sepp89117/Opel_Astra_H_opc_CAN-GaugeV2/CAN-Tools/Visual Studio/CAN-PC/WindowsApp5/Resources/OBD2.png

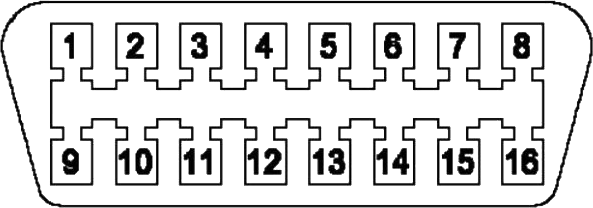
CAN-Tools/Visual Studio/CAN-PC/WindowsApp5/Resources/OBD2.png
