sepp89117/Opel_Astra_H_opc_CAN-GaugeV2/screenshots/211030_ign.jpg

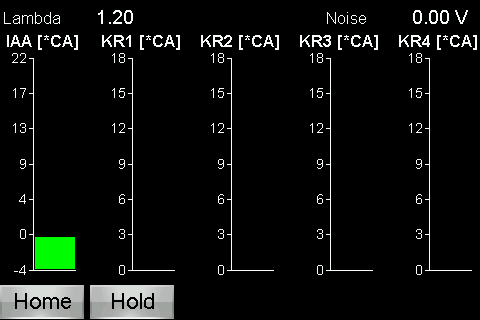
screenshots/211030_ign.jpg
