sepp89117/Opel_Astra_H_opc_CAN-GaugeV2/Display adapter.STL

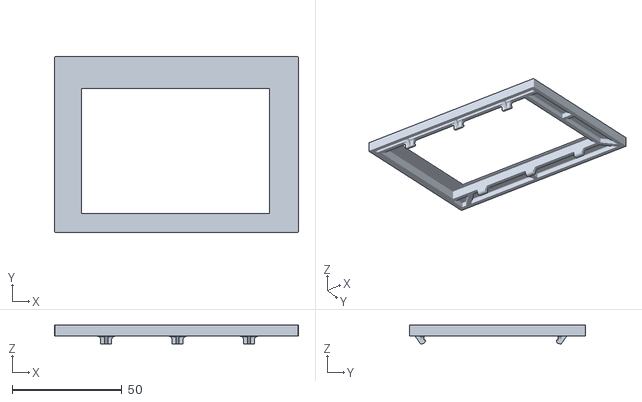
[picture p11: CAD file, 2021-05-02]
Display adapter.STL
111.0 x 80.0 x 8.42
