sepp89117/Opel_Astra_H_opc_CAN-GaugeV2/Circuit board layout files/4zollPlatine.brd

## EAGLE design Circuit board layout files/4zollPlatine.brd (2021-02-12)

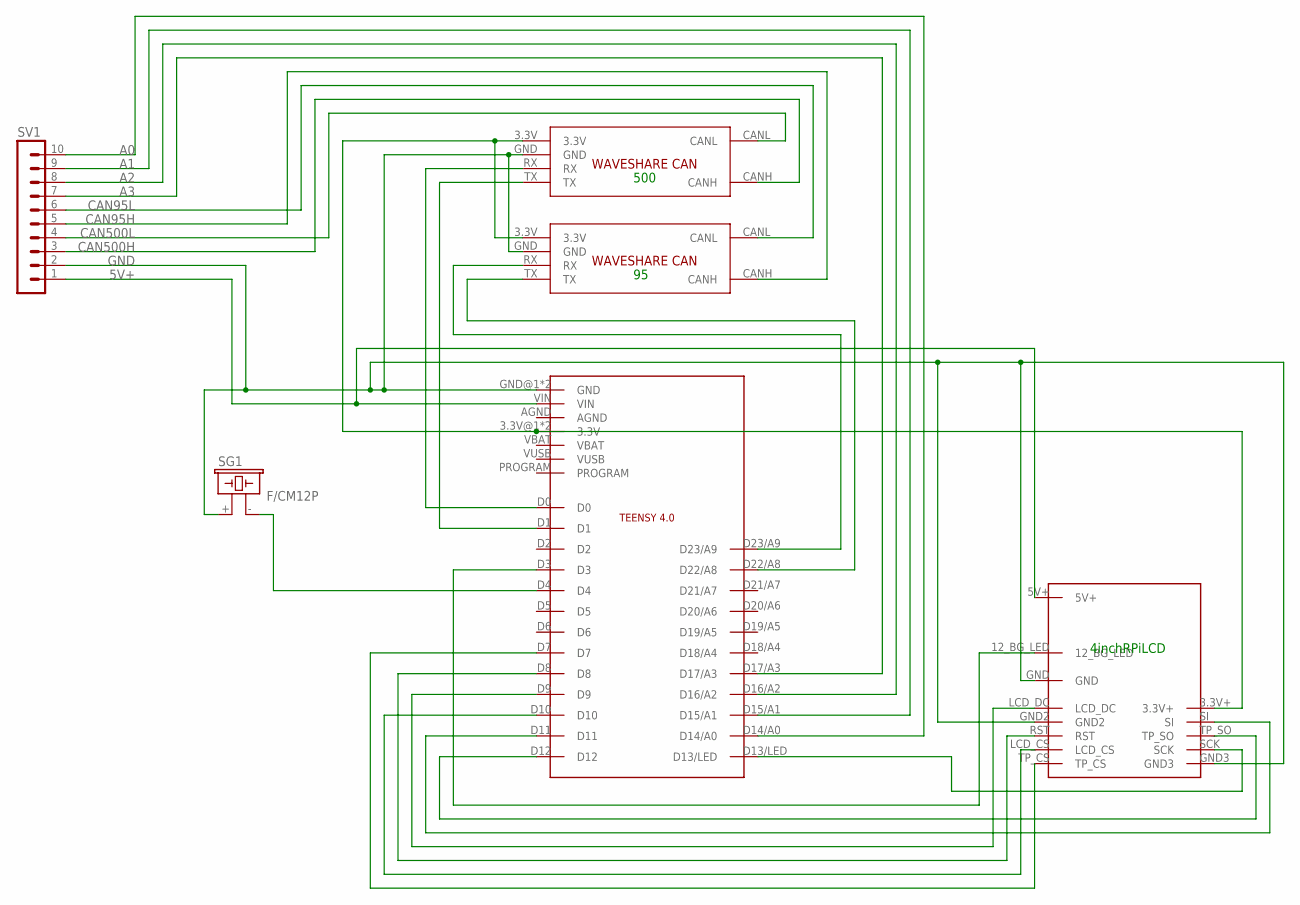
[picture p12: schematic 4zollPlatine.sch]

Parts:
95, 500: CAN_MODULE; CAN_BOARD
SG1: F/CM12P
SV1: MA10-1
U$1: TEENSY4.0
U$2: 4INCH_RPI_LCD_DEV; 4INCH_RPI_LCD_FP

Connections:
5V+: SV1.1, U$1.VIN, U$2.5V+
A0: SV1.10, U$1.D14/A0
A1: SV1.9, U$1.D15/A1
A2: SV1.8, U$1.D16/A2
A3: SV1.7, U$1.D17/A3
CAN95H: 95.CANH, SV1.5
CAN95L: 95.CANL, SV1.6
CAN500H: 500.CANH, SV1.3
CAN500L: 500.CANL, SV1.4
GND: 95.GND, 500.GND, SG1.+ (1), SV1.2, U$1.GND@1 (GND), U$1.GND@2 (GND), U$2.GND, U$2.GND2, U$2.GND3
unnamed: 95.3.3V, 500.3.3V, U$1.3.3V@1 (3.3V), U$1.3.3V@2 (3.3V), U$2.3.3V+
unnamed: U$1.D3, U$2.12_BG_LED
unnamed: SG1.- (2), U$1.D4
unnamed: U$1.D11, U$2.SI
unnamed: 500.RX, U$1.D0
unnamed: 500.TX, U$1.D1
unnamed: 95.RX, U$1.D23/A9
unnamed: 95.TX, U$1.D22/A8
unnamed: U$1.D7, U$2.TP_CS
unnamed: U$1.D10, U$2.LCD_CS
unnamed: U$1.D8, U$2.RST
unnamed: U$1.D9, U$2.LCD_DC
unnamed: U$1.D13/LED, U$2.SCK
unnamed: U$1.D12, U$2.TP_SO

Notes on the sheet:
500
4inchRPiLCD

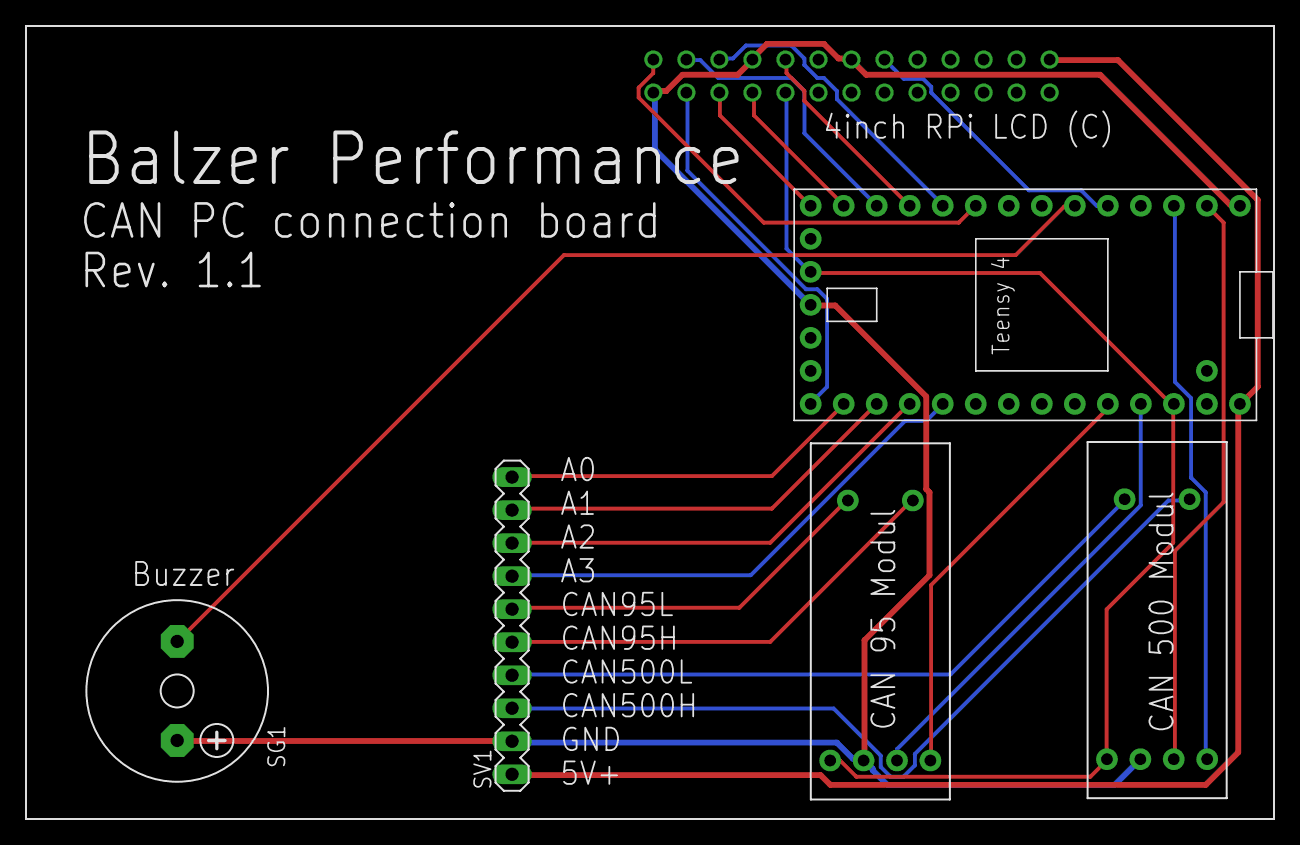
[picture p13: board 4zollPlatine.brd from above]

Board: 2 copper layers, 96.0 x 61.0 mm, 6 parts (0 on the bottom side), 24 nets.
