sepp89117/Opel_Astra_H_opc_CAN-GaugeV2/opc3BC_XL/strings.h

#ifdef DE //Deutsch
//Max-Vals
const PROGMEM char strMaxVals[] = "Maximalwerte";
const PROGMEM char strAccMon[] = "Beschleunigungs-Monitor";
const PROGMEM char strFuelMon[] = "Verbrauchs-Monitor";
const PROGMEM char strSettings[] = "Einstellungen";
const PROGMEM char strCoolant[] = "Motortemperatur";
const PROGMEM char strBoost[] = "Saugrohrdruck";
const PROGMEM char strIAT[] = "Ladelufttemp.";
const PROGMEM char strRPM[] = "Motordrehzahl";
const PROGMEM char strRpmUnit[] = "U / min";
const PROGMEM char strIgnTime[] = "Zuendzeitpunkt";
const PROGMEM char strIgnTimeUnit[] = "* vor OT";
const PROGMEM char strMaf[] = "Luftmasse";
const PROGMEM char strInjUt[] = "Injektorauslastung";
const PROGMEM char strEngStarts[] = "Motorstarts";
const PROGMEM char strPower[] = "Leistung";
const PROGMEM char strTorque[] = "Drehmoment";
const PROGMEM char strConsume[] = "Verbrauch";
//Acc-Monitor
const PROGMEM char strSpeed[] = "Geschwindigkeit";
const PROGMEM char strOdoDev[] = "Tachoabweichung";
//Fuel-View
const PROGMEM char strAvCons[] = "Durchschnittsverbrauch";
const PROGMEM char strAbsCons[] = "Absolutverbrauch";
const PROGMEM char strAvSpeed[] = "Durchschnittsgeschwindigkeit";
const PROGMEM char strDrivDist[] = "Fahrstrecke";
const PROGMEM char strDrivTime[] = "Fahrzeit";
//Settings
const PROGMEM char strSkipLogo[] = "Boot-Logo ueberspringen";
const PROGMEM char strMaxLcdBr[] = "Maximale LCD-Helligkeit";
const PROGMEM char strMinLcdBr[] = "Minimale LCD-Helligkeit";
const PROGMEM char strhandleRVolume[] = "Lautstaerke mit R-Gang anpassen";
const PROGMEM char strPlayAlarms[] = "Alarme aktivieren";
//Infos
const PROGMEM char strNoEcu[] = "ECU nicht verbunden !";
const PROGMEM char strLowFuel[] = "Kraftstoffstand niedrig!";
const PROGMEM char strCheckFl[] = "Fluessigkeiten pruefen !";
const PROGMEM char strHBR[] = "Fernlicht rechts";
const PROGMEM char strHBL[] = "Fernlicht links";
const PROGMEM char strPLR[] = "Standlicht rechts";
const PROGMEM char strPLL[] = "Standlicht links";
const PROGMEM char strLBR[] = "Abblendl. rechts";
const PROGMEM char strLBL[] = "Abblendl. links";
const PROGMEM char strBrFlE[] = "Bremsfl. leer!";
const PROGMEM char strRFL[] = "Nebelschlussleuchte";
const PROGMEM char strRevLR[] = "Rueckfahrlicht R";
const PROGMEM char strRevLL[] = "Rueckfahrlicht L";
const PROGMEM char strTSRR[] = "Blinker HR";
const PROGMEM char strTSRL[] = "Blinker HL";
const PROGMEM char strRLR[] = "Ruecklicht rechts";
const PROGMEM char strRLL[] = "Ruecklicht links";
const PROGMEM char strBLR[] = "Bremslicht rechts";
const PROGMEM char strBLL[] = "Bremslicht links";
const PROGMEM char strCoolLev[] = "Kuehlmittelstand!";
const PROGMEM char strWashLev[] = "Scheibenwaschwasser!";
//DTC View
const PROGMEM char strDelDTCs[] = "Loesche Fehlercodes...";
const PROGMEM char strNoDTCs[] = "Keine Fehlercodes";
const PROGMEM char strNoResp[] = "Keine Rueckmeldung von ECU";
//DTC verbose
const PROGMEM char strUnknwn[] = "Unbekannt";
const PROGMEM char strP00xx[] = "Sensor Umgebungslufttemperatur";
const PROGMEM char strP010x[] = "Luftmassenmesser";
const PROGMEM char strP0110[] = "Sensor Ansauglufttemperatur";
const PROGMEM char strP0115[] = "Sensor Kuehlmitteltemperatur";
const PROGMEM char strP012x[] = "Pedalpositionsgeber A";
const PROGMEM char strP013x[] = "Lambdasonde";
const PROGMEM char strP014x[] = "Lambdasonde Heizkreis";
const PROGMEM char strP017x[] = "Kraftstoffkorrektur";
const PROGMEM char strP020x[] = "Einspritzventil";
const PROGMEM char strP021x[] = "Motordrehzahl zu groß";
const PROGMEM char strP022x[] = "Pedalpositionsgeber B";
const PROGMEM char strP0230[] = "Kraftstoffpumpe Primaerkreis";
const PROGMEM char strP0235[] = "Ladedruckgeber";
const PROGMEM char strP024x[] = "Ladedruckregelventil";
const PROGMEM char strP0300[] = "Fehlzuendung mehrere Zylinder";
const PROGMEM char strP030x[] = "Fehlzuendung Zylinder";
const PROGMEM char strP031x[] = "Fehlzuendung bei leerem Tank";
const PROGMEM char strP032x[] = "Klopfsensor";
const PROGMEM char strP033x[] = "Kurbelwellensensor";
const PROGMEM char strP034x[] = "Nockenwellensensor";
const PROGMEM char strP044x[] = "Tankentlueftungssystem";
const PROGMEM char strP046x[] = "Kraftstoffstandsensor";
const PROGMEM char strP050x[] = "Fahrzeuggeschwindigkeitssignal";
const PROGMEM char strP052x[] = "Oeldruckschalter";
const PROGMEM char strP053x[] = "Klimaanlagendruck";
const PROGMEM char strP057x[] = "Bremslichtschalter";
const PROGMEM char strP060x[] = "Klopfsensor Schaltkreis";
const PROGMEM char strP062x[] = "Generator Regelung";
const PROGMEM char strP065x[] = "MIL Fehler";
const PROGMEM char strP07xx[] = "Kupplungsschalter";

#elif defined  EN //English
const PROGMEM char strNoEcu[] = "ECU not connected!";
const PROGMEM char strLowFuel[] = "Fuel level is low!";
const PROGMEM char strCheckFl[] = "Check fluids !";
const PROGMEM char strMaxVals[] = "Max values";
const PROGMEM char strAccMon[] = "Acceleration Monitor";
const PROGMEM char strFuelMon[] = "Fuel Monitor";
const PROGMEM char strSettings[] = "Settings";
const PROGMEM char strCoolant[] = "Coolant";
const PROGMEM char strBoost[] = "Boost";
const PROGMEM char strIAT[] = "Intake temp.";
const PROGMEM char strRPM[] = "Engine revs";
const PROGMEM char strRpmUnit[] = "rpm";
const PROGMEM char strIgnTime[] = "Ignition time";
const PROGMEM char strIgnTimeUnit[] = "* before TDC";
const PROGMEM char strMaf[] = "Air mass";
const PROGMEM char strInjUt[] = "Injector utilization";
const PROGMEM char strEngStarts[] = "Engine starts";
const PROGMEM char strPower[] = "Power";
const PROGMEM char strTorque[] = "Torque";
const PROGMEM char strConsume[] = "Consumption";
const PROGMEM char strSpeed[] = "Speed";
const PROGMEM char strOdoDev[] = "Speedometer dev.";
const PROGMEM char strAvCons[] = "Average consumption";
const PROGMEM char strAbsCons[] = "Absolute consumption";
const PROGMEM char strAvSpeed[] = "Average speed";
const PROGMEM char strDrivDist[] = "Driving distance";
const PROGMEM char strDrivTime[] = "Travel time";
const PROGMEM char strSkipLogo[] = "Skip boot logo";
const PROGMEM char strMaxLcdBr[] = "Maximum LCD brightness";
const PROGMEM char strMinLcdBr[] = "Minimum LCD brightness";
const PROGMEM char strhandleRVolume[] = "Adjust volume with R-gear";
const PROGMEM char strPlayAlarms[] = "Activate alarms";
const PROGMEM char strHBR[] = "High beam right";
const PROGMEM char strHBL[] = "High beam left";
const PROGMEM char strPLR[] = "Parking light right";
const PROGMEM char strPLL[] = "Parking light left";
const PROGMEM char strLBR[] = "Low beam right";
const PROGMEM char strLBL[] = "Low beam left";
const PROGMEM char strBrFlE[] = "Brake fl. empty!";
const PROGMEM char strRFL[] = "Rear fog light";
const PROGMEM char strRevLR[] = "Reversing light R";
const PROGMEM char strRevLL[] = "Reversing light L";
const PROGMEM char strTSRR[] = "Turn signal R";
const PROGMEM char strTSRL[] = "Turn signal L";
const PROGMEM char strRLR[] = "Taillight right";
const PROGMEM char strRLL[] = "Taillight left";
const PROGMEM char strBLR[] = "Brake light right";
const PROGMEM char strBLL[] = "Brake light left";
const PROGMEM char strCoolLev[] = "Coolant level!";
const PROGMEM char strWashLev[] = "Washer fluid!";
const PROGMEM char strDelDTCs[] = "Clear error codes ...";
const PROGMEM char strNoDTCs[] = "No error codes";
const PROGMEM char strNoResp[] = "No response from ECU ";
const PROGMEM char strUnknwn[] = "Unknown";
const PROGMEM char strP00xx[] = "Sensor ambient air temperature";
const PROGMEM char strP010x[] = "air mass meter";
const PROGMEM char strP0110[] = "Sensor intake air temperature";
const PROGMEM char strP0115[] = "Sensor coolant temperature";
const PROGMEM char strP012x[] = "Pedal position transmitter A";
const PROGMEM char strP013x[] = "Lambda probe";
const PROGMEM char strP014x[] = "Lambda probe heating circuit";
const PROGMEM char strP017x[] = "fuel correction";
const PROGMEM char strP020x[] = "injector";
const PROGMEM char strP021x[] = "Motor speed too high";
const PROGMEM char strP022x[] = "Pedal position transmitter B";
const PROGMEM char strP0230[] = "fuel pump primary circuit";
const PROGMEM char strP0235[] = "boost pressure sensor";
const PROGMEM char strP024x[] = "boost pressure control valve";
const PROGMEM char strP0300[] = "Multiple cylinders misfire";
const PROGMEM char strP030x[] = "misfire on cylinder";
const PROGMEM char strP031x[] = "Incorrect ignition when the tank is empty";
const PROGMEM char strP032x[] = "knock sensor";
const PROGMEM char strP033x[] = "crankshaft sensor";
const PROGMEM char strP034x[] = "camshaft sensor";
const PROGMEM char strP044x[] = "Tank ventilation system";
const PROGMEM char strP046x[] = "fuel level sensor";
const PROGMEM char strP050x[] = "vehicle speed signal";
const PROGMEM char strP052x[] = "Oil pressure switch";
const PROGMEM char strP053x[] = "air conditioning pressure";
const PROGMEM char strP057x[] = "brake light switch";
const PROGMEM char strP060x[] = "Knock Sensor Circuit";
const PROGMEM char strP062x[] = "Generator control";
const PROGMEM char strP065x[] = "MIL error";
const PROGMEM char strP07xx[] = "clutch switch";

#elif defined FR //France
const PROGMEM char strNoEcu[] = "ECU non connecte!";
const PROGMEM char strLowFuel[] = "Le niveau de carburant est bas!";
const PROGMEM char strCheckFl[] = "Verifiez les fluides!";
const PROGMEM char strMaxVals[] = "Valeurs maximales";
const PROGMEM char strAccMon[] = "Moniteur d'acceleration";
const PROGMEM char strFuelMon[] = "Moniteur de carburant";
const PROGMEM char strSettings[] = "Parametres";
const PROGMEM char strCoolant[] = "Liquide de refroidissement";
const PROGMEM char strBoost[] = "Pression du collecteur";
const PROGMEM char strIAT[] = "Temp d'admission.";
const PROGMEM char strRPM[] = "Tours du moteur";
const PROGMEM char strRpmUnit[] = "rpm";
const PROGMEM char strIgnTime[] = "Temps d'allumage";
const PROGMEM char strIgnTimeUnit[] = "* avant TDC";
const PROGMEM char strMaf[] = "Masse d'air";
const PROGMEM char strInjUt[] = "Utilisation de l'injecteur";
const PROGMEM char strEngStarts[] = "Le moteur demarre";
const PROGMEM char strPower[] = "Puissance";
const PROGMEM char strTorque[] = "Couple";
const PROGMEM char strConsume[] = "Consommation";
const PROGMEM char strSpeed[] = "Vitesse";
const PROGMEM char strOdoDev[] = "Compteur de vitesse dev.";
const PROGMEM char strAvCons[] = "Consommation moyenne";
const PROGMEM char strAbsCons[] = "Consommation absolue";
const PROGMEM char strAvSpeed[] = "Vitesse moyenne";
const PROGMEM char strDrivDist[] = "Distance parcourue";
const PROGMEM char strDrivTime[] = "Temps de trajet";
const PROGMEM char strSkipLogo[] = "Ignorer le logo de demarrage";
const PROGMEM char strMaxLcdBr[] = "Luminosite maximale de l'ecran LCD";
const PROGMEM char strMinLcdBr[] = "Luminosite minimale de l'ecran LCD";
const PROGMEM char strhandleRVolume[] = "Reglez volume avec engrenage R";
const PROGMEM char strPlayAlarms[] = "Activer les alarmes";
const PROGMEM char strHBR[] = "Feux de route a droite";
const PROGMEM char strHBL[] = "Feux de route gauche";
const PROGMEM char strPLR[] = "Feu de stationnement a droite";
const PROGMEM char strPLL[] = "Feu de stationnement gauche";
const PROGMEM char strLBR[] = "Feu de croisement a droite";
const PROGMEM char strLBL[] = "Feu de croisement gauche";
const PROGMEM char strBrFlE[] = "Frein fl. vide!";
const PROGMEM char strRFL[] = "Feu antibrouillard arriere";
const PROGMEM char strRevLR[] = "Feu de recul R";
const PROGMEM char strRevLL[] = "Feu de recul L";
const PROGMEM char strTSRR[] = "Clignotant R";
const PROGMEM char strTSRL[] = "Clignotant L";
const PROGMEM char strRLR[] = "Feu arriere droit";
const PROGMEM char strRLL[] = "Feu arriere gauche";
const PROGMEM char strBLR[] = "Feu stop a droite";
const PROGMEM char strBLL[] = "Feu stop gauche";
const PROGMEM char strCoolLev[] = "Niveau liq. refroidissement!";
const PROGMEM char strWashLev[] = "Liquide lave-glace!";
const PROGMEM char strDelDTCs[] = "Effacer les codes d'erreur ...";
const PROGMEM char strNoDTCs[] = "Aucun code d'erreur";
const PROGMEM char strNoResp[] = "Aucune reponse de l'ECU";
const PROGMEM char strUnknwn[] = "Unknown";
const PROGMEM char strP00xx[] = "Temperature de l'air ambiant du capteur";
const PROGMEM char strP010x[] = "Debitmetre d'air massique";
const PROGMEM char strP0110[] = "Temperature de l'air d'admission du capteur";
const PROGMEM char strP0115[] = "Temperature du liquide de refroidissement du capteur";
const PROGMEM char strP012x[] = "Transmetteur de position de pedale A";
const PROGMEM char strP013x[] = "Sonde Lambda";
const PROGMEM char strP014x[] = "Circuit de chauffage de la sonde Lambda";
const PROGMEM char strP017x[] = "Correction de carburant";
const PROGMEM char strP020x[] = "Injecteur";
const PROGMEM char strP021x[] = "Vitesse du moteur trop elevee";
const PROGMEM char strP022x[] = "Transmetteur de position de pedale B";
const PROGMEM char strP0230[] = "Circuit primaire de la pompe a carburant";
const PROGMEM char strP0235[] = "Capteur de pression de suralimentation";
const PROGMEM char strP024x[] = "Vanne de regulation de pression de suralimentation";
const PROGMEM char strP0300[] = "Plusieurs cylindres ont des rates d'allumage";
const PROGMEM char strP030x[] = "Rate d'allumage sur le cylindre";
const PROGMEM char strP031x[] = "Allumage incorrect lorsque le reservoir est vide";
const PROGMEM char strP032x[] = "Capteur de cliquetis";
const PROGMEM char strP033x[] = "Capteur de vilebrequin";
const PROGMEM char strP034x[] = "Capteur d'arbre a cames";
const PROGMEM char strP044x[] = "Systeme de ventilation du reservoir";
const PROGMEM char strP046x[] = "Capteur de niveau de carburant";
const PROGMEM char strP050x[] = "Signal de vitesse du vehicule";
const PROGMEM char strP052x[] = "Pressostat d'huile";
const PROGMEM char strP053x[] = "Pression de climatisation";
const PROGMEM char strP057x[] = "Interrupteur des feux stop";
const PROGMEM char strP060x[] = "Circuit du capteur de cliquetis";
const PROGMEM char strP062x[] = "Contrôle du generateur";
const PROGMEM char strP065x[] = "Erreur MIL";
const PROGMEM char strP07xx[] = "Interrupteur d'embrayage";

#elif defined RO //Romanian
const PROGMEM char strMaxVals[] = "valori maxime";
const PROGMEM char strAccMon[] = "Monitor accelerare";
const PROGMEM char strFuelMon[] = "Monitor consum";
const PROGMEM char strSettings[] = "Setari";
const PROGMEM char strCoolant[] = "temperatura motorului";
const PROGMEM char strBoost[] = "presiunea galeriei de admisie";
const PROGMEM char strIAT[] = "Temp. aer de incarcare.";
const PROGMEM char strRPM[] = "viteza motorului";
const PROGMEM char strRpmUnit[] = "RPM";
const PROGMEM char strIgnTime[] = "timp de aprindere";
const PROGMEM char strIgnTimeUnit[] = "* inainte de OT";
const PROGMEM char strMaf[] = "masa de aer";
const PROGMEM char strInjUt[] = "Utilizarea injectorului";
const PROGMEM char strEngStarts[] = "Motorul porneste";
const PROGMEM char strPower[] = "putere";
const PROGMEM char strTorque[] = "Cuplu";
const PROGMEM char strConsume[] = "Consum";
// Monitor Acc
const PROGMEM char strSpeed[] = "viteza";
const PROGMEM char strOdoDev[] = "Abaterea vitezometrului";
// Vedere combustibil
const PROGMEM char strAvCons[] = "Consum mediu";
const PROGMEM char strAbsCons[] = "consum absolut";
const PROGMEM char strAvSpeed[] = "Viteza medie";
const PROGMEM char strDrivDist[] = "Distanta de parcurs";
const PROGMEM char strDrivTime[] = "Timp de condus";
// Setari
const PROGMEM char strSkipLogo[] = "omite sigla de pornire";
const PROGMEM char strMaxLcdBr[] = "Luminozitatea maxima a ecranului LCD";
const PROGMEM char strMinLcdBr[] = "Luminozitatea minima a LCD-ului";
const PROGMEM char strhandleRVolume[] = "Reglati volumul cu marsarier";
const PROGMEM char strPlayAlarms[] = "Activare alarme";
//Informatii
const PROGMEM char strNoEcu[] = "ECU nu este conectat!";
const PROGMEM char strLowFuel[] = "Nivel de combustibil scazut!";
const PROGMEM char strCheckFl[] = "Verificati fluidele!";
const PROGMEM char strHBR[] = "faza lunga dreapta";
const PROGMEM char strHBL[] = "faza lunga stanga";
const PROGMEM char strPLR[] = "lumin de parcare dreapta";
const PROGMEM char strPLL[] = "Lumina de parcare stanga";
const PROGMEM char strLBR[] = "Reducerea luminii la dreapta";
const PROGMEM char strLBL[] = "Dimmer stanga";
const PROGMEM char strBrFlE[] = "Frana fl. gol!";
const PROGMEM char strRFL[] = "lumina de ceata spate";
const PROGMEM char strRevLR[] = "Lumina de marsarier R";
const PROGMEM char strRevLL[] = "Lumina de marsarier L";
const PROGMEM char strTSRR[] = "Blinker HR";
const PROGMEM char strTSRL[] = "Blinker HL";
const PROGMEM char strRLR[] = "lumina spate dreapta";
const PROGMEM char strRLL[] = "lumina spate stanga";
const PROGMEM char strBLR[] = "Lumina de frana dreapta";
const PROGMEM char strBLL[] = "Lumina de frana stanga";
const PROGMEM char strCoolLev[] = "Nivel lichid de racire!";
const PROGMEM char strWashLev[] = "Lichid de spalat parbriz!";
// Vizualizare DTC
const PROGMEM char strDelDTCs[] = "sterge codurile de eroare...";
const PROGMEM char strNoDTCs[] = "Fara coduri de eroare";
const PROGMEM char strNoResp[] = "Fara feedback de la ECU";
// DTC verbose
const PROGMEM char strUnknwn[] = "Unknown";
const PROGMEM char strP00xx[] = "Senzor temperatura aerului ambiant";
const PROGMEM char strP010x[] = "contor masei de aer";
const PROGMEM char strP0110[] = "Senzor temperatura aerului admis";
const PROGMEM char strP0115[] = "Senzor temperatura lichid de racire";
const PROGMEM char strP012x[] = "Transmitatorul pozitiei pedalei A";
const PROGMEM char strP013x[] = "Sonda lambda";
const PROGMEM char strP014x[] = "Circuit de incalzire sonda lambda";
const PROGMEM char strP017x[] = "corectie combustibil";
const PROGMEM char strP020x[] = "Supapa de injectie";
const PROGMEM char strP021x[] = "Viteza motorului prea mare";
const PROGMEM char strP022x[] = "Transmitator de pozitie a pedalei B";
const PROGMEM char strP0230[] = "Circuit primar al pompei de combustibil";
const PROGMEM char strP0235[] = "senzor presiune de supraalimentare";
const PROGMEM char strP024x[] = "supapa de reglare a presiunii de supraalimentare";
const PROGMEM char strP0300[] = "Mai multe cilindri au fost aprinse incorect";
const PROGMEM char strP030x[] = "rautarea cilindrului";
const PROGMEM char strP031x[] = "Aprindere incorecta cand rezervorul este gol";
const PROGMEM char strP032x[] = "senzor de detonare";
const PROGMEM char strP033x[] = "senzor arbore cotit";
const PROGMEM char strP034x[] = "Senzor arbore cu came";
const PROGMEM char strP044x[] = "Sistem de ventilatie rezervor";
const PROGMEM char strP046x[] = "senzor de nivel de combustibil";
const PROGMEM char strP050x[] = "semnal de viteza vehiculului";
const PROGMEM char strP052x[] = "Comutator de presiune ulei";
const PROGMEM char strP053x[] = "Presiune aer conditionat";
const PROGMEM char strP057x[] = "Comutator lumini de frana";
const PROGMEM char strP060x[] = "Circuit senzor de detonare";
const PROGMEM char strP062x[] = "Control generator";
const PROGMEM char strP065x[] = "Eroare MIL";
const PROGMEM char strP07xx[] = "comutator ambreiaj";
#endif
