sepp89117/Opel_Astra_H_opc_CAN-GaugeV2/opc3BC_XL/ILI9486_fonts.h

// https://github.com/kurte/ILI9486_t3n
// http://forum.pjrc.com/threads/26305-Highly-optimized-ILI9486-(320x240-TFT-color-display)-library
//
// ILI Font file definition.
#ifndef _ILI9486_FONTS_H_
#define _ILI9486_FONTS_H_
typedef struct {
	const unsigned char *index;
	const unsigned char *unicode;
	const unsigned char *data;
	unsigned char version;
	unsigned char reserved;
	unsigned char index1_first;
	unsigned char index1_last;
	unsigned char index2_first;
	unsigned char index2_last;
	unsigned char bits_index;
	unsigned char bits_width;
	unsigned char bits_height;
	unsigned char bits_xoffset;
	unsigned char bits_yoffset;
	unsigned char bits_delta;
	unsigned char line_space;
	unsigned char cap_height;
} ILI9486_t3_font_t;
#endif
