sepp89117/Opel_Astra_H_opc_CAN-GaugeV2/opc3BC_XL/ili9486_t3n_font_ArialBold.h

#ifndef _ILI9486_t3n_font_ArialBold_
#define _ILI9486_t3n_font_ArialBold_

#include "ILI9486_fonts.h"

#ifdef __cplusplus
extern "C" {
#endif

extern const ILI9486_t3_font_t Arial_8_Bold;
extern const ILI9486_t3_font_t Arial_9_Bold;
extern const ILI9486_t3_font_t Arial_10_Bold;
extern const ILI9486_t3_font_t Arial_11_Bold;
extern const ILI9486_t3_font_t Arial_12_Bold;
extern const ILI9486_t3_font_t Arial_13_Bold;
extern const ILI9486_t3_font_t Arial_14_Bold;
extern const ILI9486_t3_font_t Arial_16_Bold;
extern const ILI9486_t3_font_t Arial_18_Bold;
extern const ILI9486_t3_font_t Arial_20_Bold;
extern const ILI9486_t3_font_t Arial_24_Bold;
extern const ILI9486_t3_font_t Arial_28_Bold;
extern const ILI9486_t3_font_t Arial_32_Bold;
extern const ILI9486_t3_font_t Arial_40_Bold;
extern const ILI9486_t3_font_t Arial_48_Bold;
extern const ILI9486_t3_font_t Arial_60_Bold;
extern const ILI9486_t3_font_t Arial_72_Bold;
extern const ILI9486_t3_font_t Arial_96_Bold;

#ifdef __cplusplus
} // extern "C"
#endif

#endif
