sepp89117/Opel_Astra_H_opc_CAN-GaugeV2/opc3BC_XL/opcNumFont9486.cpp

#include "opcNumFont9486.h"

static const unsigned char opcNumFont_data[] = {
  0x07, 0xD8, 0x2B, 0xC0, 0x50, 0x08, 0xFF, 0xE0, 0x20, 0x00, 0x00, 0x05, 0xD8, 0x23, 0xC1, 0xE0, 
  0xA0, 0x57, 0xDF, 0x08, 0xD8, 0x2E, 0x01, 0xC0, 0xD6, 0x1D, 0x63, 0x96, 0x71, 0x6E, 0x13, 0xC0, 
  0xE0, 0x0E, 0xD8, 0x48, 0x1F, 0x80, 0xFF, 0xC8, 0x7F, 0xF9, 0xF9, 0xFF, 0xFC, 0x3F, 0xDF, 0x0F, 
  0xBF, 0x3F, 0x87, 0xFF, 0x87, 0xFE, 0x03, 0xF0, 0x0A, 0xD8, 0x38, 0x0F, 0x83, 0xF0, 0xFE, 0x3F, 
  0xCF, 0xFC, 0x7F, 0xEF, 0x7D, 0xCF, 0xB1, 0xF4, 0x3F, 0xE0, 0xFE, 0x03, 0xE0, 0x7C, 0x0E, 0xD8, 
  0x48, 0x1F, 0x80, 0xFF, 0xC8, 0x7F, 0xF9, 0xF9, 0xFD, 0x7C, 0x3E, 0x00, 0x7E, 0x00, 0x3F, 0x00, 
  0xFD, 0x00, 0x7E, 0x01, 0xF8, 0x07, 0xE1, 0x03, 0xF0, 0x0F, 0xC0, 0x3F, 0x00, 0xFC, 0x02, 0xBF, 
  0xFF, 0x7F, 0xFE, 0x0E, 0xD8, 0x44, 0x1F, 0x80, 0xFF, 0xC8, 0x7F, 0xF9, 0xF9, 0xFC, 0xFC, 0x3F, 
  0x00, 0x0F, 0x80, 0x3E, 0x03, 0xFD, 0x00, 0xFE, 0x01, 0xFE, 0x00, 0x7D, 0x20, 0x0F, 0xCF, 0xC3, 
  0xEF, 0xCF, 0xE1, 0xFF, 0xE1, 0xFF, 0x80, 0xFC, 0x00, 0x10, 0xD8, 0x4E, 0x00, 0x7F, 0x20, 0x0F, 
  0xF2, 0x01, 0xFF, 0x01, 0xFF, 0x80, 0xF7, 0xC8, 0x1F, 0x7C, 0x83, 0xE7, 0xC8, 0x7C, 0x7C, 0x8F, 
  0x87, 0xCA, 0xFF, 0xFF, 0xC0, 0x07, 0xC0, 0x03, 0xE0, 0x0E, 0xD8, 0x46, 0xFF, 0xFF, 0xAF, 0x80, 
  0x1F, 0x7C, 0x3F, 0xFC, 0x7F, 0xFC, 0xFF, 0xFD, 0xF9, 0xFC, 0x7C, 0x3F, 0x40, 0x0F, 0xC7, 0xC3, 
  0xEF, 0xCF, 0xCF, 0xFF, 0x9F, 0xFE, 0x1F, 0xF8, 0x0F, 0xC0, 0x0E, 0xD8, 0x44, 0x1F, 0x80, 0xFF, 
  0xC8, 0x7F, 0xF9, 0xF9, 0xFC, 0x7C, 0x3F, 0x1F, 0x00, 0x3E, 0xF8, 0x7F, 0xF9, 0x1F, 0xFF, 0x3F, 
  0x3F, 0xEF, 0x87, 0xDF, 0x9F, 0xC3, 0xFF, 0xC3, 0xFF, 0x01, 0xF8, 0x00, 0x0E, 0xD8, 0x46, 0xBF, 
  0xFF, 0x00, 0x3F, 0x00, 0x0F, 0x00, 0x3E, 0x80, 0x0F, 0x20, 0x07, 0xC8, 0x01, 0xE2, 0x00, 0xF8, 
  0x01, 0xE1, 0x00, 0xF8, 0x01, 0xE0, 0x90, 0xF8, 0x01, 0xE0, 0x07, 0xC0, 0x0F, 0x00, 0x3E, 0x00, 
  0x0E, 0xD8, 0x44, 0x1F, 0x80, 0xFF, 0xC3, 0xFF, 0xCF, 0xFF, 0xDF, 0x9F, 0xDF, 0xC3, 0xEF, 0xCF, 
  0xE1, 0xFF, 0xE0, 0xFF, 0x07, 0xFF, 0x8F, 0x9F, 0x67, 0xC3, 0xEF, 0xCF, 0xDF, 0xFF, 0x9F, 0xFE, 
  0x1F, 0xF8, 0x0F, 0xC0, 0x0E, 0xD8, 0x44, 0x1F, 0x80, 0xFF, 0xC8, 0x7F, 0xF9, 0xF9, 0xFE, 0xFC, 
  0x3E, 0xFC, 0xFE, 0x1F, 0xFF, 0x1F, 0xFE, 0x1F, 0x7E, 0x00, 0x1F, 0x9F, 0x87, 0xDF, 0x9F, 0xC3, 
  0xFF, 0xC3, 0xFF, 0x01, 0xF8, 0x00
};
/* Size: 358 bytes */

static const unsigned char opcNumFont_index[] = {
  0x00, 0x02, 0xC2, 0x62, 0x11, 0xC1, 0x38, 0xE6, 0x99, 0x5C, 0xB6, 0x9F, 0x92, 0x0A, 0x20
};
/* Size: 15 bytes */

const ILI9486_t3_font_t opcNumFont_28 = {
    opcNumFont_index,
    0,
    opcNumFont_data,
    1,
    0,
    45,
    57,
    0,
    0,
    9,
    5,
    5,
    2,
    2,
    5,
    0,
    27
};
