sepp89117/Opel_Astra_H_opc_CAN-GaugeV2/opc3BC_XL/opcNumFont9486.h

#ifndef __opcNumFont_h__
#define __opcNumFont_h__

#include "ILI9486_fonts.h"

#ifdef __cplusplus
extern "C" {
#endif

extern const ILI9486_t3_font_t opcNumFont_28;

#ifdef __cplusplus
} // extern "C"
#endif

#endif
