sepp89117/Opel_Astra_H_opc_CAN-GaugeV2/(commit log)

2021-01-31 Update opc3BC_XL.ino
    Correction value for atmospheric pressure added
    [opc3BC_XL.ino]
2021-02-12 Add files via upload
    EAGLE files for connection board
    [4zollPlatine.brd, 4zollPlatine.sch, old4zollPlatine.brd]
2021-03-27 Update opc3BC_XL.ino
    Added knock retard values and corrected ignition spark angle value calculation
    [opc3BC_XL.ino]
2021-04-03 Newest Version of CAN-Analysis
    [CAN-analysis.xlsx]
2021-05-02 Adapter for mounting in original display housing
    [Display adapter.STL]
2022-07-30 Update opc3BC_XL.ino
    Gear indicator added and fix for display type a/c
    [opc3BC_XL.ino]
2022-07-30 Update ILI9486_t3n.h
    Fix for display type a/c
    [ILI9486_t3n.h]
2024-06-24 Add files via upload
    The tools, which I used together with an Arduino Uno and a CAN-BUS Shield V1.2 for reverse engineering.
    https://wiki.seeedstudio.com/CAN-BUS_Shield_V1.2/
2024-06-29 Add files via upload
    Optional code for usage with UART CAN modules
